ElipsonSynergy/ThermoForge/PCB/View/tfg-et-v1.jpg

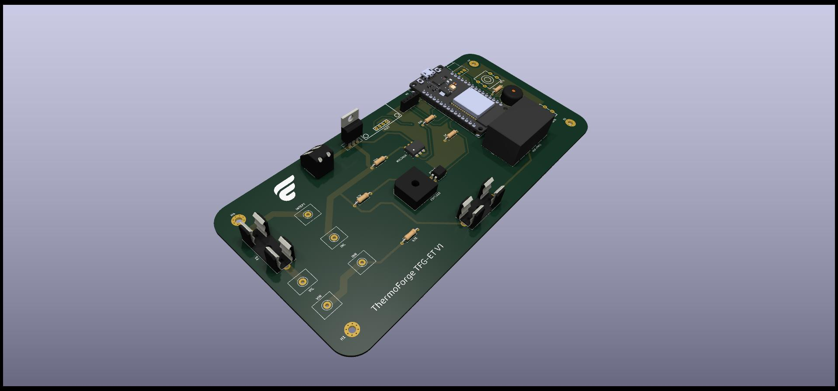
PCB/View/tfg-et-v1.jpg
