ElipsonSynergy/ThermoForge/Documentation/images/controlPID.jpg

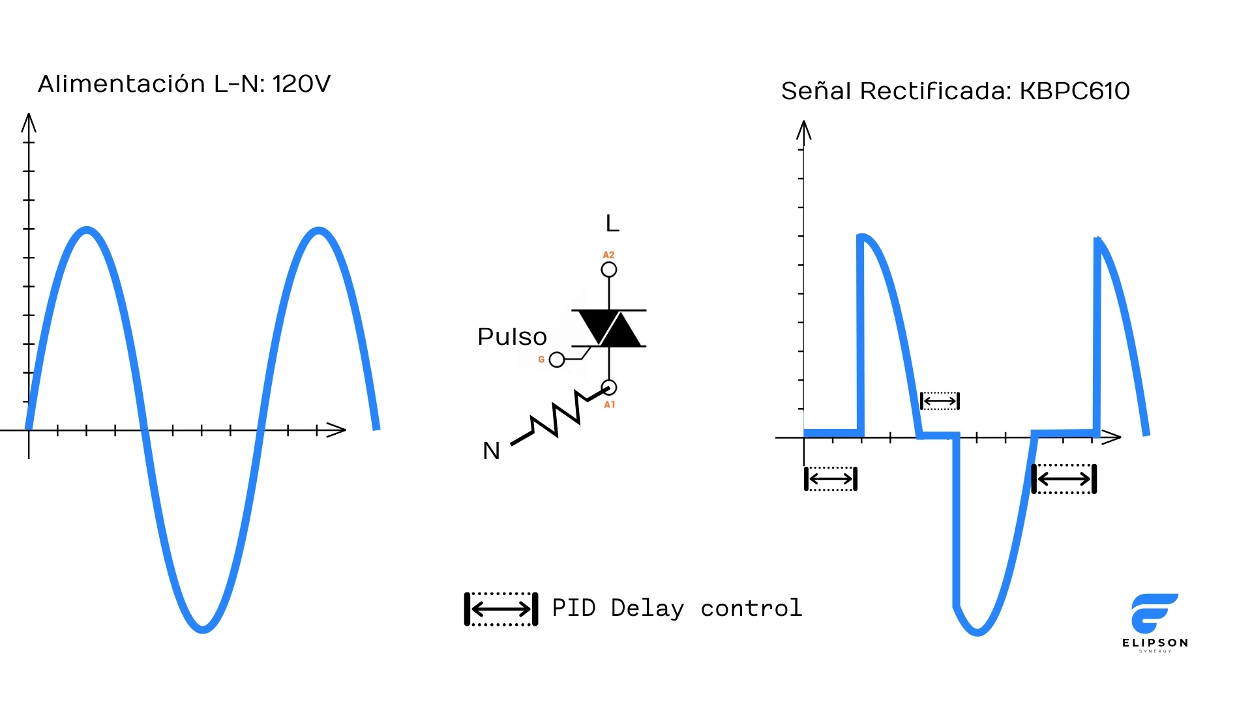
Documentation/images/controlPID.jpg
