ElipsonSynergy/ThermoForge/3D/Termoformadora/tfg53.step

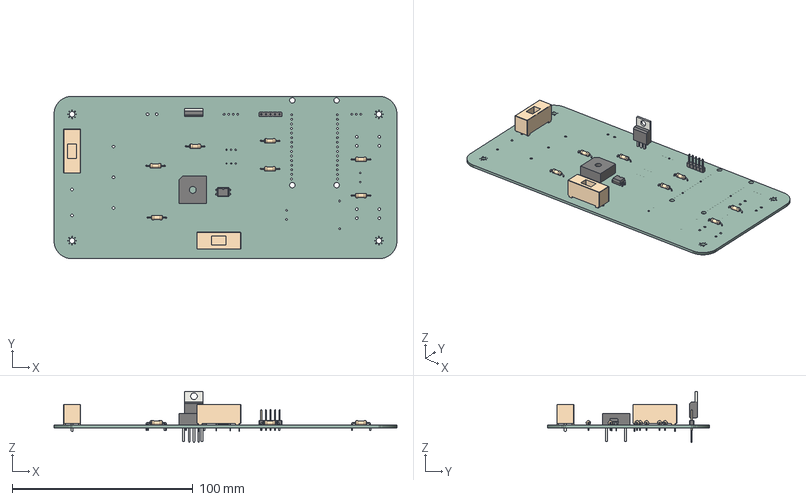
[picture p20: CAD file, 2024-11-26]
3D/Termoformadora/tfg53.step
190.0 x 90.0 x 28.5 mm
PCB
