ElipsonSynergy/ThermoForge/(list of files, cad)

Other CAD files:
3D/Termoformadora/Metal.dwg
3D/Termoformadora/Base.ipt
3D/Termoformadora/Lat1(2).ipt
3D/Termoformadora/Lat1(3).ipt
3D/Termoformadora/Lat1.ipt
3D/Termoformadora/Lat2.ipt
3D/Termoformadora/Lat3.ipt
3D/Termoformadora/Manija1.ipt
3D/Termoformadora/Manija2.ipt
3D/Termoformadora/Manija3.ipt
3D/Termoformadora/Metal1.ipt
3D/Termoformadora/Metal2.ipt
3D/Termoformadora/OldVersions/Base.0005.ipt
3D/Termoformadora/OldVersions/Lat1(2).0003.ipt
3D/Termoformadora/OldVersions/Lat1(3).0001.ipt
3D/Termoformadora/OldVersions/Lat1.0003.ipt
3D/Termoformadora/OldVersions/Lat2.0008.ipt
3D/Termoformadora/OldVersions/Lat3.0005.ipt
3D/Termoformadora/OldVersions/Manija1.0001.ipt
3D/Termoformadora/OldVersions/Manija2.0002.ipt
3D/Termoformadora/OldVersions/Manija3.0001.ipt
3D/Termoformadora/OldVersions/Metal2.0001.ipt
3D/Termoformadora/OldVersions/Soporte1.0001.ipt
3D/Termoformadora/OldVersions/Tapa1.0004.ipt
3D/Termoformadora/OldVersions/Tapa2.0003.ipt
3D/Termoformadora/OldVersions/TapaLateral.0002.ipt
3D/Termoformadora/OldVersions/Termo.0011.iam
3D/Termoformadora/Resistencia.ipt
3D/Termoformadora/Soporte1.ipt
3D/Termoformadora/Tapa1.ipt
3D/Termoformadora/Tapa2.ipt
3D/Termoformadora/TapaLateral.ipt
3D/Termoformadora/Termo.iam
