ElipsonSynergy/ThermoForge/3D/Despiezado.pdf

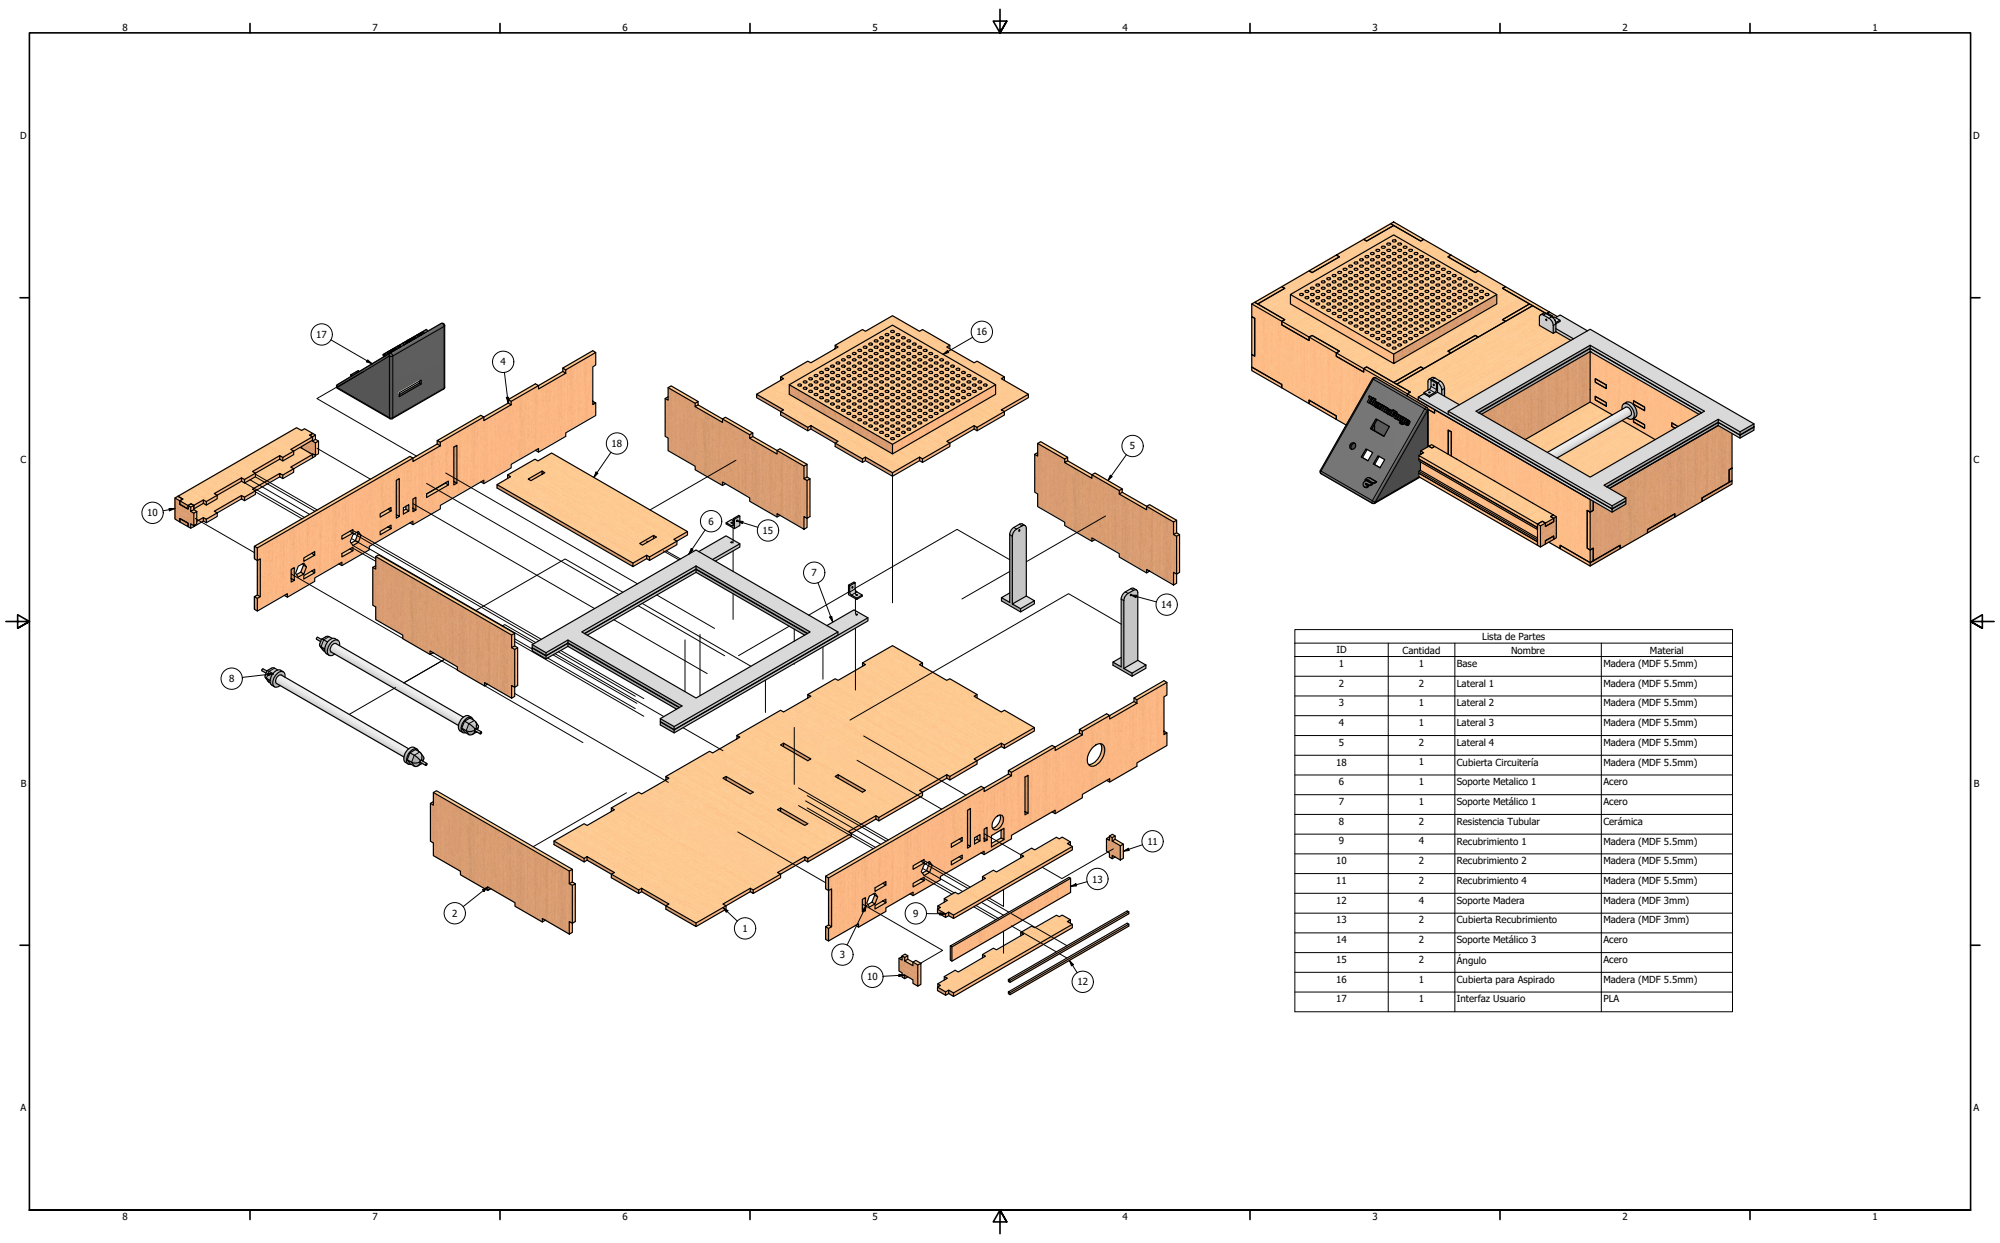
[picture p21: page 1]

I D | C a n 1 t i d a d | Base N o m b r e | Madera (MDF 5.5m M a t e r i al 1

6 | 1 | S o p o r t e M e t ali c o 1 | A c e r o

7 | 1 | S o p o r t e M e t áli c o 1 | A c e r o

8 | 2 | Re s i s t e n c i a T u b ula r | C e r á m i c a

1 4 | 2 | S o p o r t e M e t áli c o 3 | A c e r o

1 5 | 2 | Á n g ulo | A c e r o
