ElipsonSynergy/ThermoForge/3D/Dimensiones.pdf

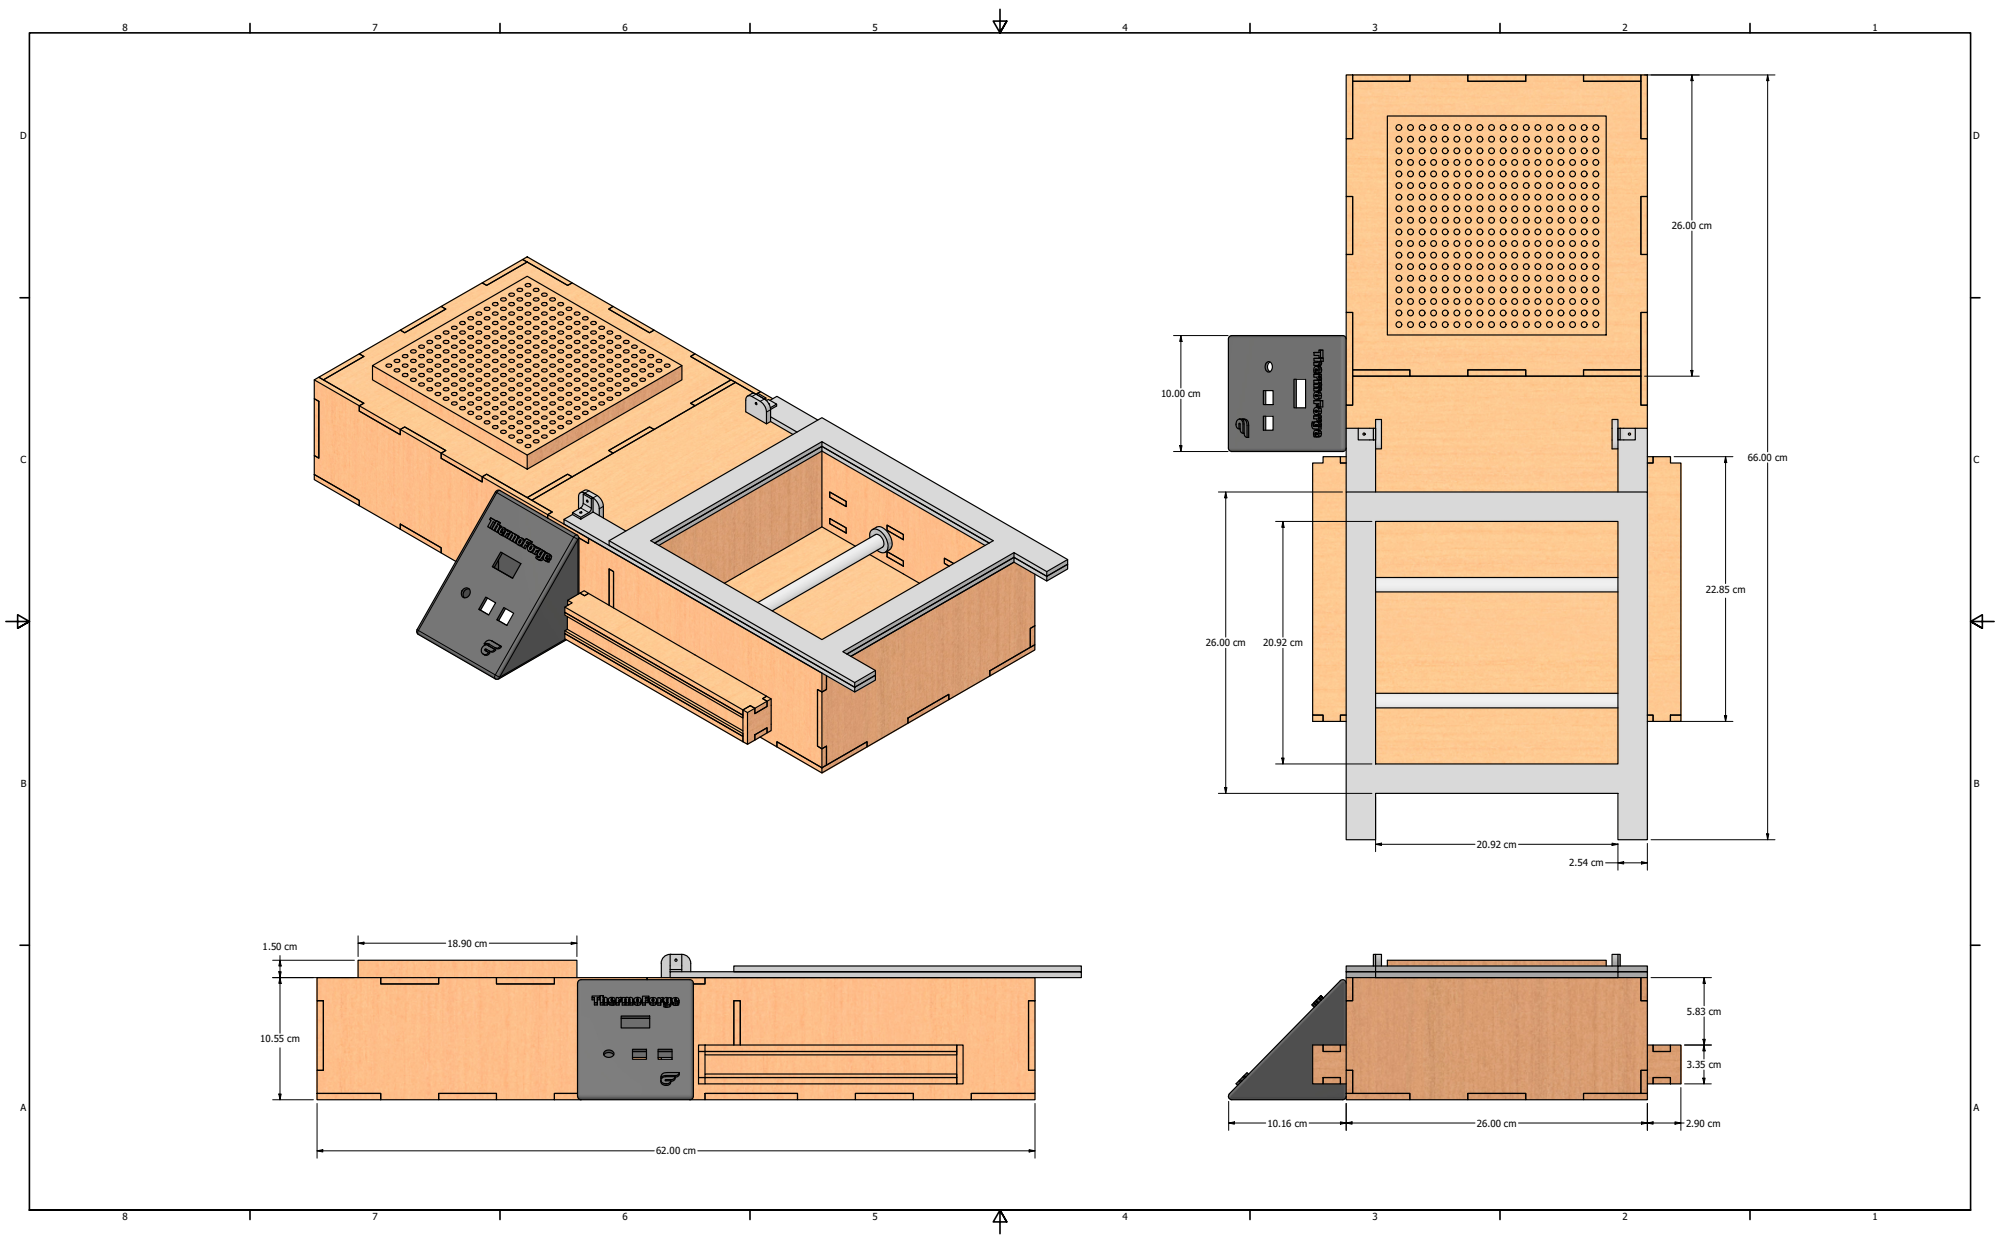
[picture p22: page 1]
