ElipsonSynergy/ThermoForge/PCB/View/tfg-et-v1.pdf

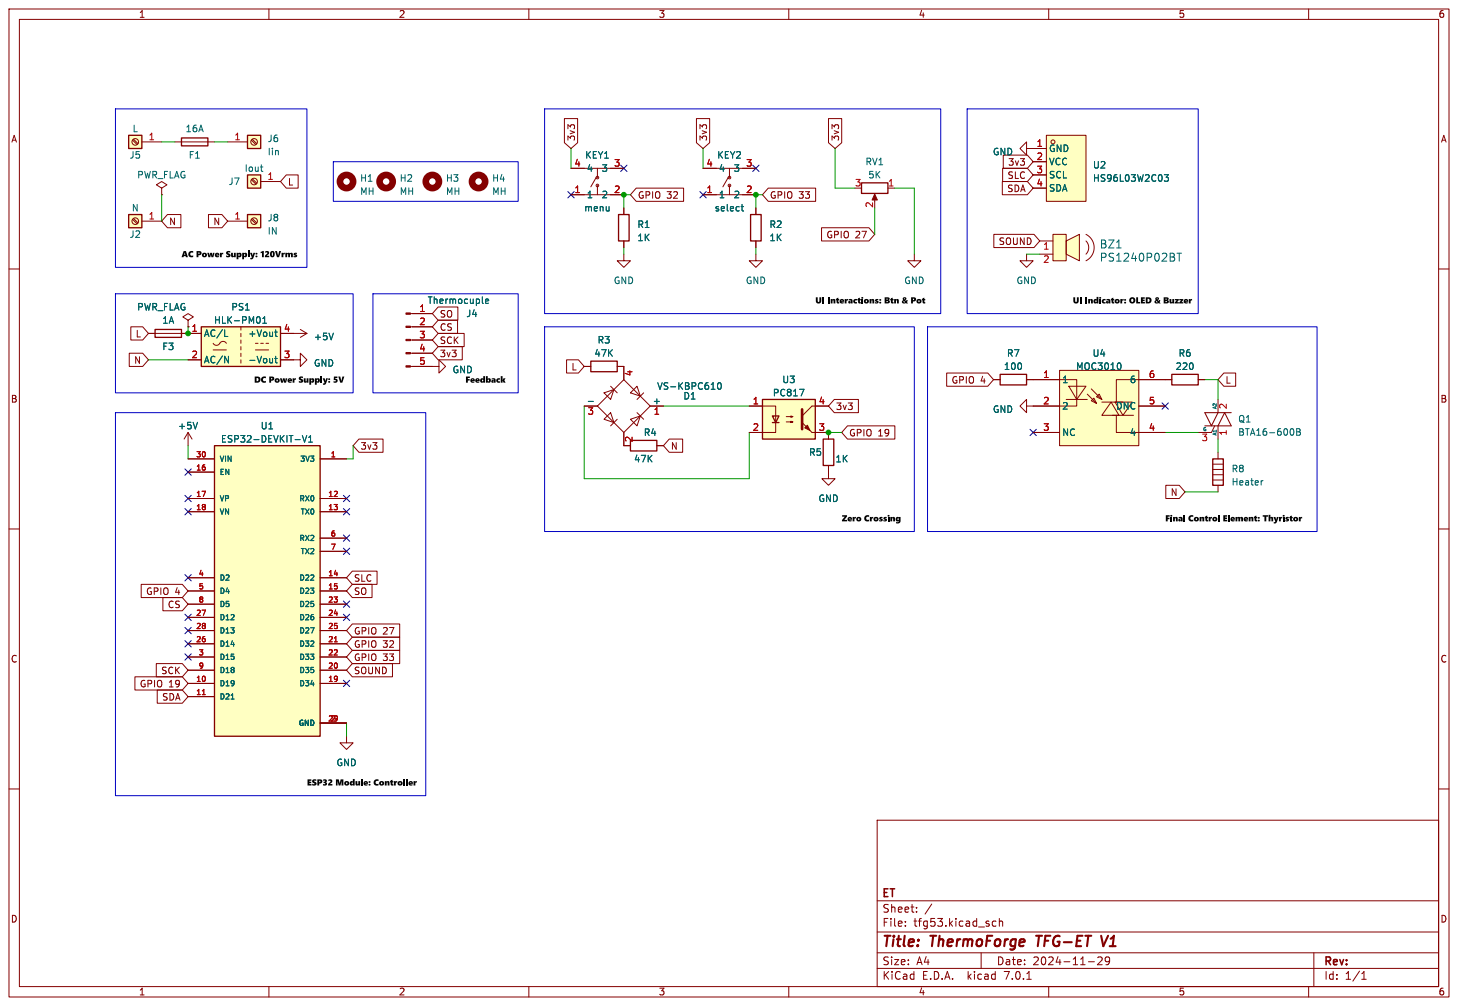
[picture p23: page 1]

Id: 1/1 Title: ThermoForge TFG-ET V1
