ElipsonSynergy/ThermoForge/PCB/View/fab/tfg53-B_Cu.pdf

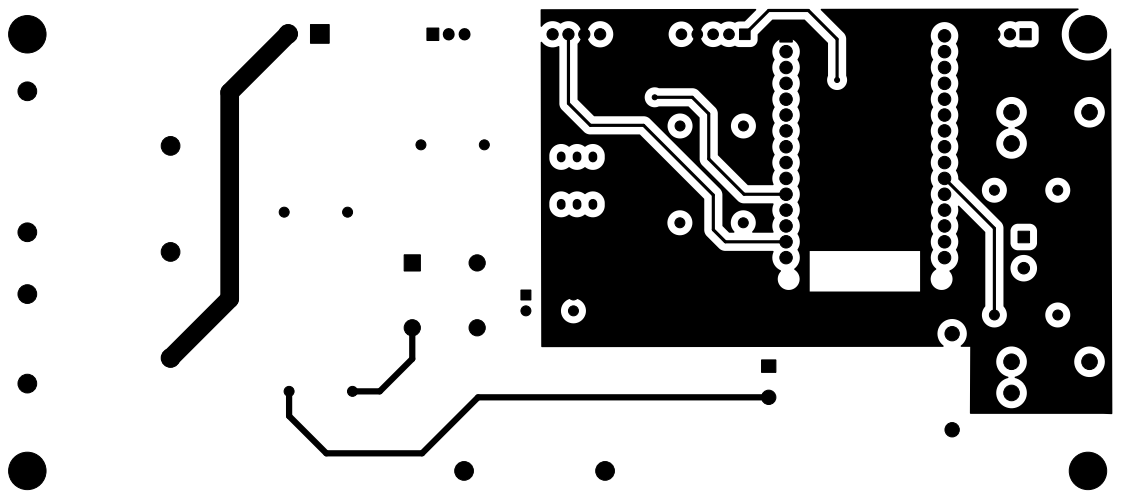
[picture p24: page 1]
