ElipsonSynergy/ThermoForge/PCB/View/fab/tfg53-Edge_Cuts.pdf

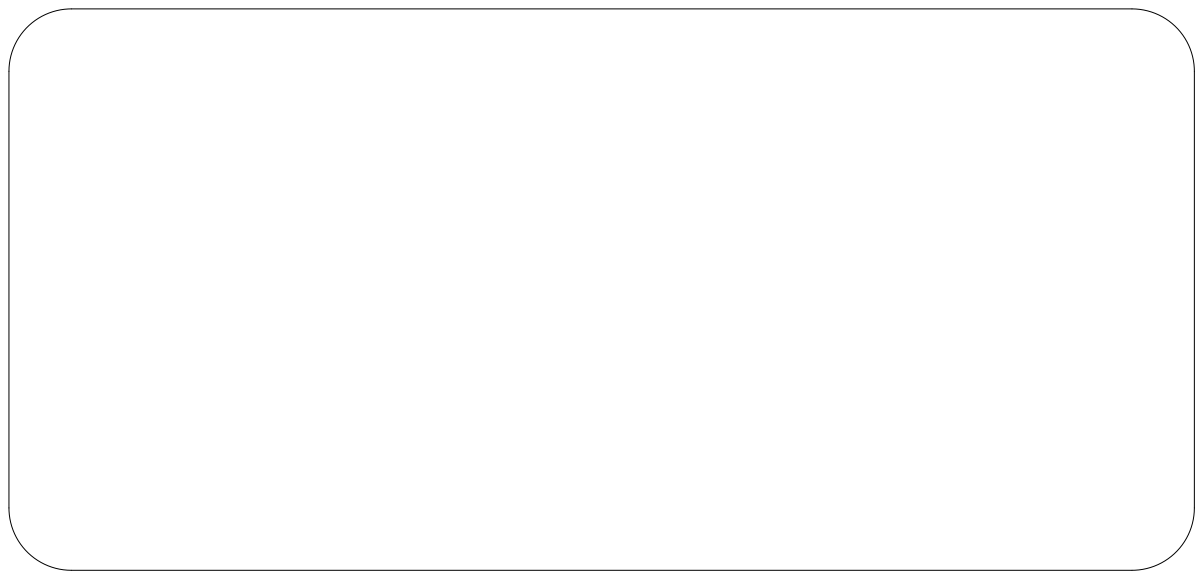
[picture p25: page 1]
