ElipsonSynergy/ThermoForge/PCB/View/fab/tfg53-F_Cu.pdf

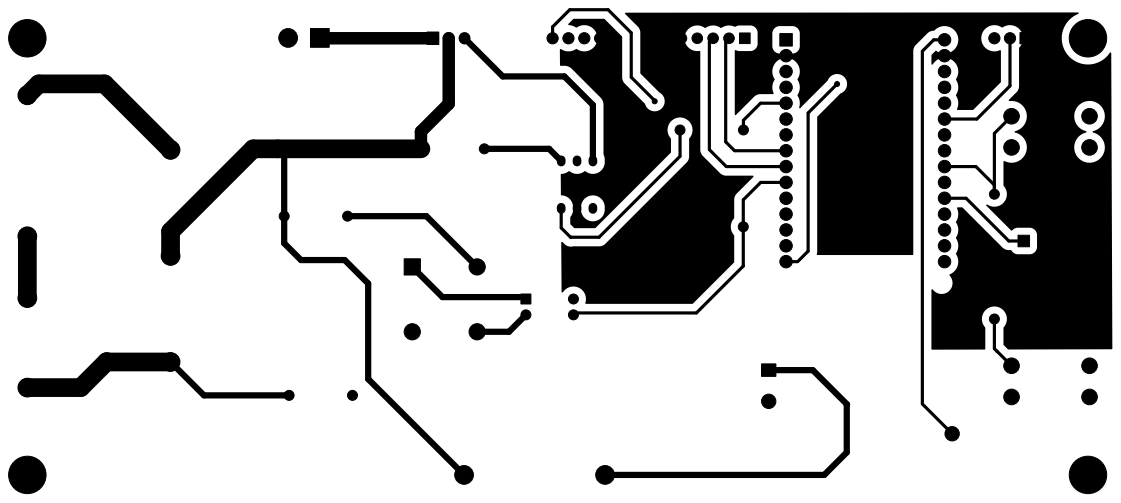
[picture p26: page 1]
