ElipsonSynergy/ThermoForge/PCB/View/fab/tfg53-F_Mask.pdf

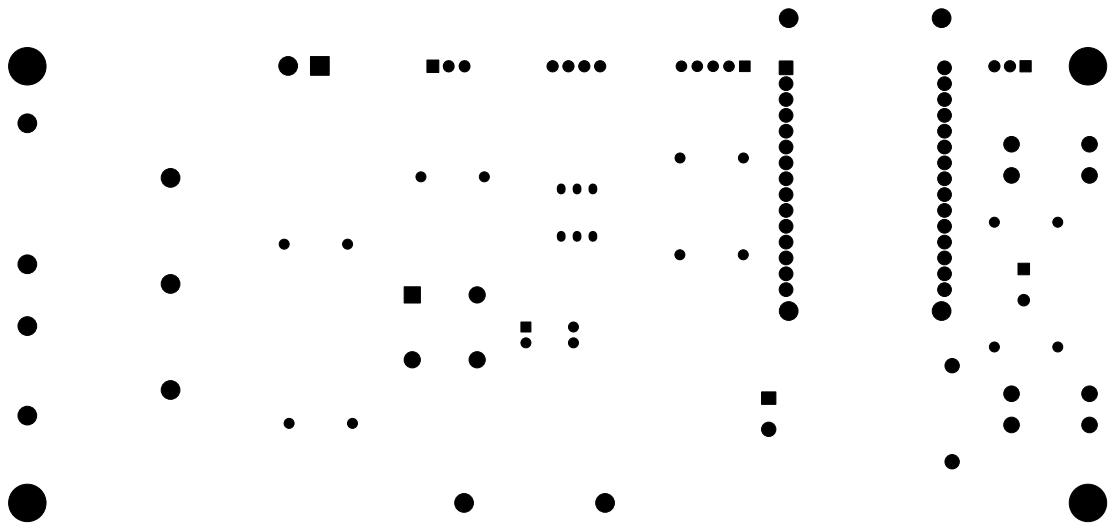
[picture p27: page 1]
