ElipsonSynergy/ThermoForge/PCB/View/fab/tfg53-F_Silkscreen.pdf

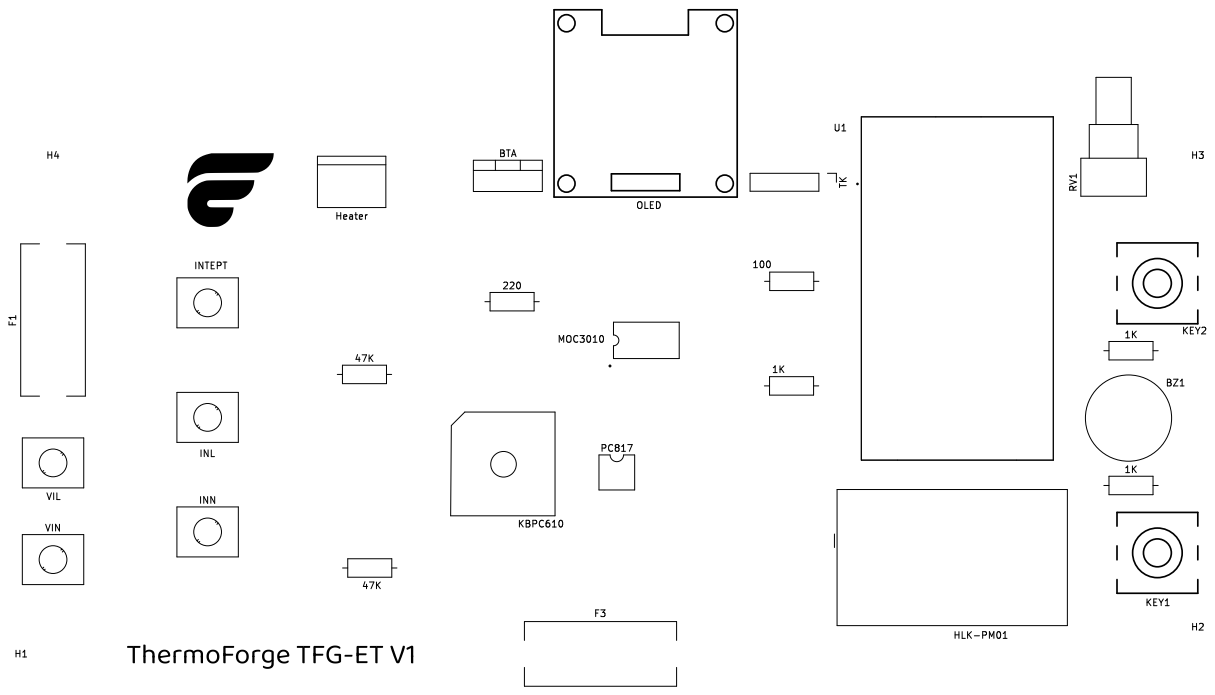
[picture p28: page 1]
