ElipsonSynergy/ThermoForge/PCB/TFG53/tfg53.kicad_pcb

## KiCad design PCB/TFG53/tfg53.kicad_pcb (2024-11-30)

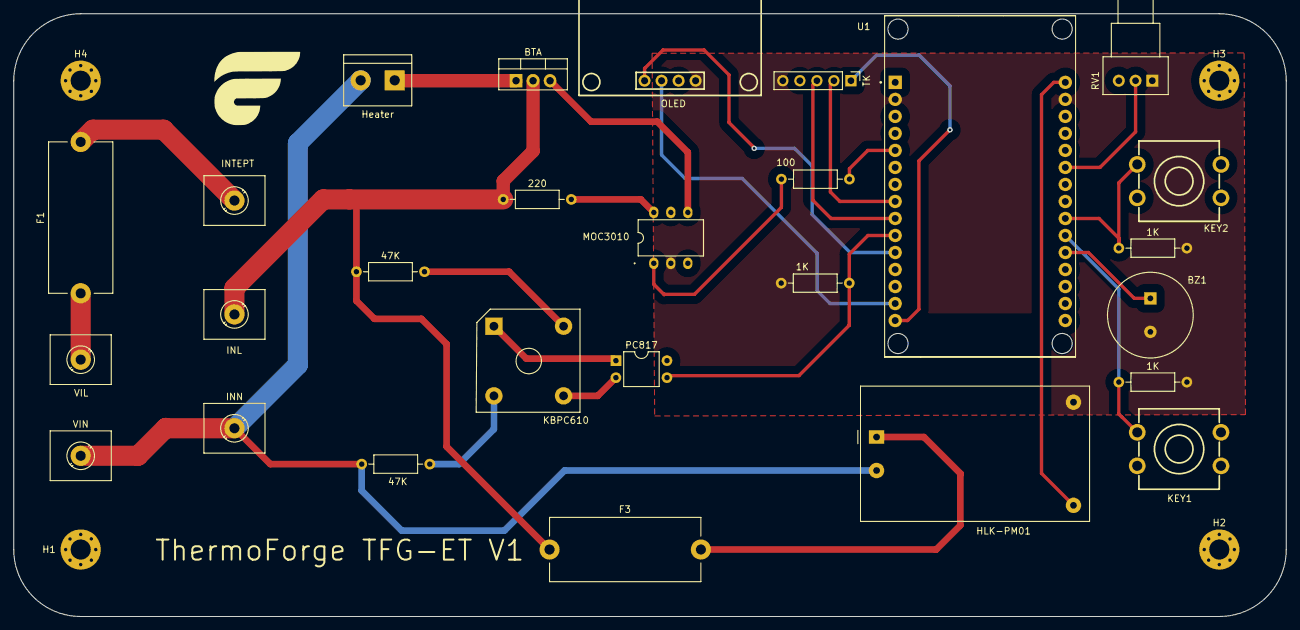
[picture p29: board tfg53.kicad_pcb from above]

Board: 2 copper layers, 190.0 x 90.0 mm, 31 parts (0 on the bottom side), 27 nets.

Parts:
1K, 1K#2, 1K#3: 1K; R_Axial_DIN0207_L6.3mm_D2.5mm_P10.16mm_Horizontal
47K, 47K#2: 47K; R_Axial_DIN0207_L6.3mm_D2.5mm_P10.16mm_Horizontal
100: 100; R_Axial_DIN0207_L6.3mm_D2.5mm_P10.16mm_Horizontal
220: 220; R_Axial_DIN0207_L6.3mm_D2.5mm_P10.16mm_Horizontal
BTA: BTA16-600B; TO-220-3_Vertical
BZ1: PS1240P02BT; Piezo_Transducer_THT_PS1240P02BT
F1: 16A; Fuseholder_Cylinder-5x20mm_Stelvio-Kontek_PTF78_Horizontal_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
F3: 1A; Fuseholder_Cylinder-5x20mm_Stelvio-Kontek_PTF78_Horizontal_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
H1, H2, H3, H4: MH; MountingHole_3mm_Pad_Via
HLK-PM01: HLK-PM01; Converter_ACDC_HiLink_HLK-PMxx
Heater: Heater; TerminalBlock_bornier-2_P5.08mm
INL: Iout; TerminalBlock_MetzConnect_360271_1x01_Horizontal_ScrewM3.0_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
INN: IN; TerminalBlock_MetzConnect_360271_1x01_Horizontal_ScrewM3.0_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
INTEPT: Iin; TerminalBlock_MetzConnect_360271_1x01_Horizontal_ScrewM3.0_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
KBPC610: VS-KBPC610; Diode_Bridge_Vishay_KBPC6
KEY1: menu; KEY-TH_4P-L12.0-W12.0-P5.00-LS13.4
KEY2: select; KEY-TH_4P-L12.0-W12.0-P5.00-LS13.4
MOC3010: MOC3010; DIP-6_L9.6-W6.4-P2.54-LS7.6-BL
OLED: HS96L03W2C03; OLED-TH_L27.8-W27.2-P2.54_C9900033791
PC817: PC817; DIP-4_W7.62mm
RV1: 5K; Potentiometer_Alps_RK09Y11_Single_Horizontal
TK: Thermocuple; PinHeader_1x05_P2.54mm_Vertical
U1: ESP32-DEVKIT-V1; MODULE_ESP32_DEVKIT_V1
VIL: L; TerminalBlock_MetzConnect_360271_1x01_Horizontal_ScrewM3.0_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
VIN: N; TerminalBlock_MetzConnect_360271_1x01_Horizontal_ScrewM3.0_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

Connections:
3v3: KEY1.4, KEY2.4, OLED.2 (VCC), PC817.4, RV1.3, TK.4, U1.1 (3V3)
+5V: HLK-PM01.4 (+Vout), U1.30 (VIN)
CS: TK.2, U1.8 (D5)
GND: 1K.1, 1K#2.2, 1K#3.2, BZ1.2, HLK-PM01.3 (-Vout), MOC3010.2, OLED.1 (GND), RV1.1, TK.5, U1.2 (GND), U1.29 (GND)
GPIO 4: 100.2, U1.5 (D4)
GPIO 19: 1K.2, PC817.3, U1.10 (D19)
GPIO 27: RV1.2, U1.25 (D27)
GPIO 32: 1K#3.1, KEY1.2, U1.21 (D32)
GPIO 33: 1K#2.1, KEY2.2, U1.22 (D33)
L: 47K.1, 220.1, BTA.2 (A2), F3.1, INL.1
N: 47K#2.2, HLK-PM01.2 (AC/N), Heater.2, INN.1, VIN.1
unnamed: KBPC610.1 (+), PC817.1
unnamed: KBPC610.3 (-), PC817.2
unnamed: 47K#2.1, KBPC610.2
unnamed: 47K.2, KBPC610.4
unnamed: F1.1, VIL.1
unnamed: F1.2, INTEPT.1
unnamed: F3.2, HLK-PM01.1 (AC/L)
unnamed: BTA.1 (A1), Heater.1
unnamed: BTA.3 (G), MOC3010.4
unnamed: 220.2, MOC3010.6
unnamed: 100.1, MOC3010.1
SCK: TK.3, U1.9 (D18)
SDA: OLED.4 (SDA), U1.11 (D21)
SLC: OLED.3 (SCL), U1.14 (D22)
SO: TK.1, U1.15 (D23)
SOUND: BZ1.1, U1.20 (D35)
