ElipsonSynergy/ThermoForge/Code/src/pins.h

#ifndef PINS_H
#define PINS_H

#include <Arduino.h>

/**
 * @brief Pines de conexión a ESP 32.
 *
 * Se definen los pines de las conexiones para los diferentes dispositivos.
 */
#define thermoDO  23
#define thermoCS  5
#define thermoCLK  18

#define zeroCrossing 19
#define triac 4

#define selectBtn  2
#define menuBtn  15
#define spinBtn  4

#define sound 35

#define SCL 22
#define SDA 21



#endif 
