ElipsonSynergy/ThermoForge/(commit log)

2024-11-11 Power supply & Interface PCB
    [tfg53.kicad_pcb, tfg53.kicad_sch]
2024-11-12 Optoacoplador MOC3010 added
    [tfg53.kicad_sch]
2024-11-18 Termocuple code
    [tfg53.kicad_sch]
2024-11-26 Placa terminada
    [Base.0005.ipt, Base.ipt, Lat1(2).0003.ipt, Lat1(2).ipt, Lat1(3).0001.ipt, Lat1(3).ipt, Lat1.0003.ipt, Lat1.ipt]
2024-11-26 Gerber files
    [tfg53-B_Cu.gbr, tfg53-B_Mask.gbr, tfg53-B_Paste.gbr, tfg53-B_Silkscreen.gbr, tfg53-Edge_Cuts.gbr, tfg53-F_Cu.gbr, tfg53-F_Mask.gbr, tfg53-F_Paste.gbr]
2024-11-30 PCB view
    [tfg53-B_Cu.gbr, tfg53-B_Mask.gbr, tfg53-B_Paste.gbr, tfg53-B_Silkscreen.gbr, tfg53-Edge_Cuts.gbr, tfg53-F_Cu.gbr, tfg53-F_Mask.gbr, tfg53-F_Paste.gbr]
2024-11-30 PID declarado
2024-12-01 Deadline I
    [Base.0005.ipt, Base.ipt, Lat1(2).0003.ipt, Lat1(2).ipt, Lat1(3).0001.ipt, Lat1(3).ipt, Lat1.0003.ipt, Lat1.ipt]
2024-12-09 Some backups
    [Base.0005.ipt, Base.ipt, Lat1(2).0003.ipt, Lat1(2).ipt, Lat1(3).0001.ipt, Lat1(3).ipt, Lat1.0003.ipt, Lat1.ipt]
